letrend/kicad_db/_3Dmodels/SJ-63063B--3DModel-STEP-1.STEP

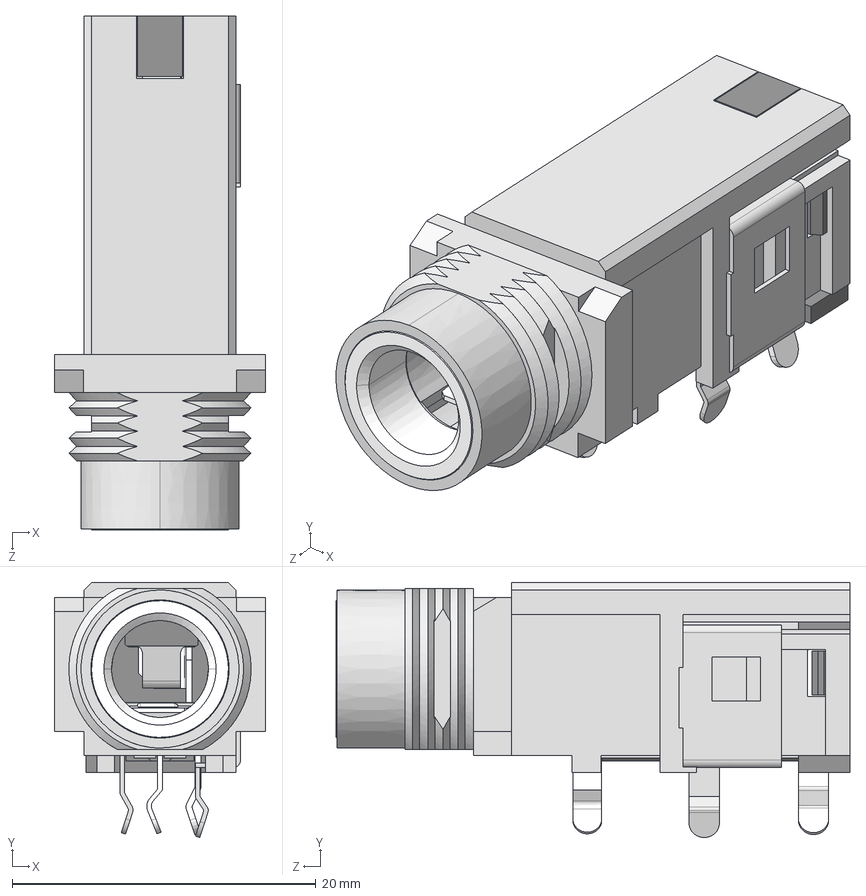
[picture p1: CAD file, 2025-12-29]
_3Dmodels/SJ-63063B--3DModel-STEP-1.STEP
13.9 x 16.8 x 33.9 mm
630BT-1
630LS-1
PRT0003-1
630C2-1
630GZ-1
