letrend/kicad_db/_3Dmodels/FH28K-20S-0.5SH.stp

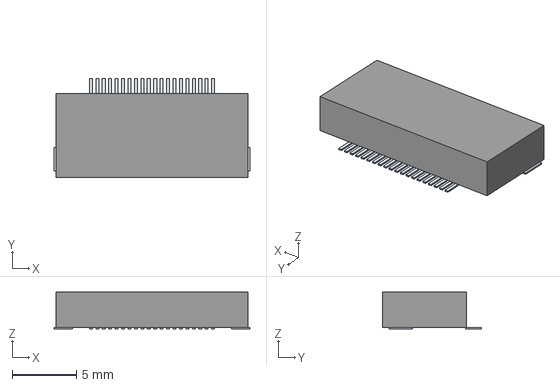
[picture p2: CAD file, 2025-12-13]
_3Dmodels/FH28K-20S-0.5SH.stp
15.2 x 7.67 x 2.85 mm
Pins
