letrend/kicad_db/_3Dmodels/UQFN20_NC_MCH.step

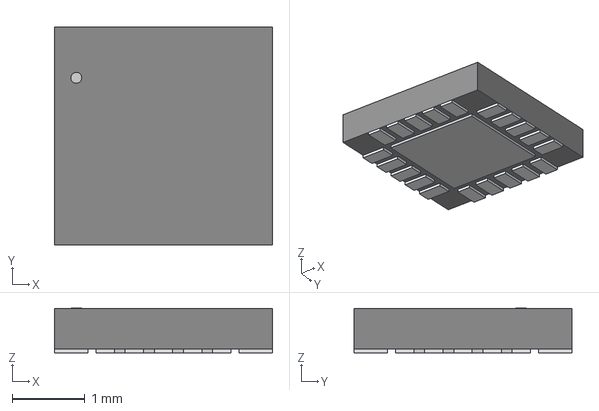
[picture p3: CAD file, 2025-12-13]
_3Dmodels/UQFN20_NC_MCH.step
3.00 x 3.00 x 0.612 mm
