letrend/kicad_db/_3Dmodels/MP6619 (QFN-19, 3x3).step

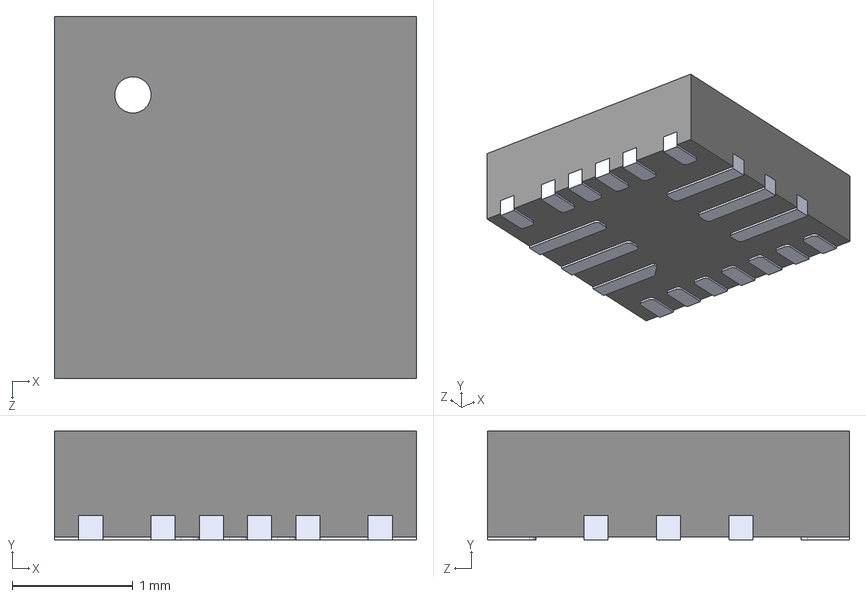
[picture p4: CAD file, 2025-12-13]
_3Dmodels/MP6619 (QFN-19, 3x3).step
3.00 x 0.9 x 3.00 mm
