letrend/kicad_db/_3Dmodels/A1308LLHLT-1-T.stp

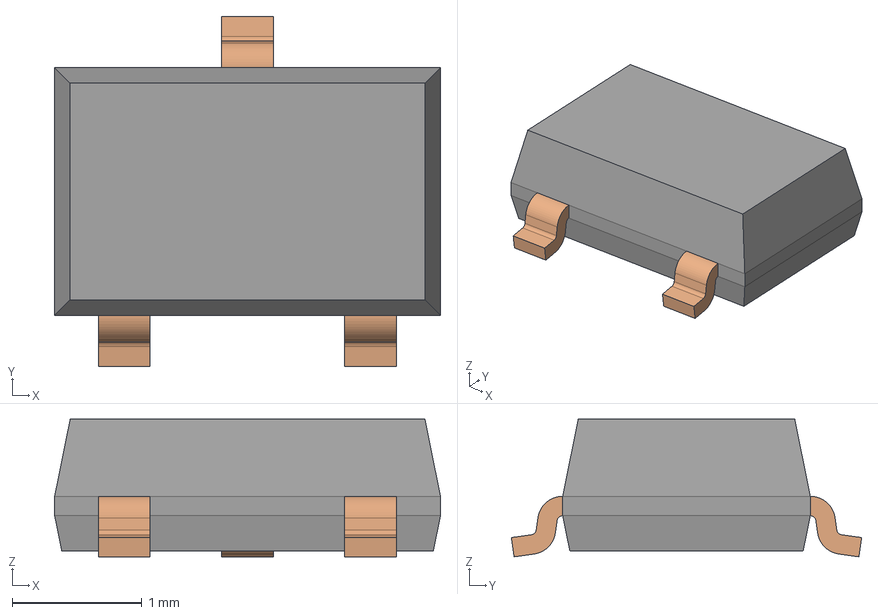
[picture p5: CAD file, 2025-10-07]
_3Dmodels/A1308LLHLT-1-T.stp
2.98 x 2.70 x 1.06 mm
LH1
LH2
LH3
LH4
LH5
LH6
LH-body
