letrend/kicad_db/_3Dmodels/DRV8825_STEPPER_MOTOR_DRIVER_CARRIER.step

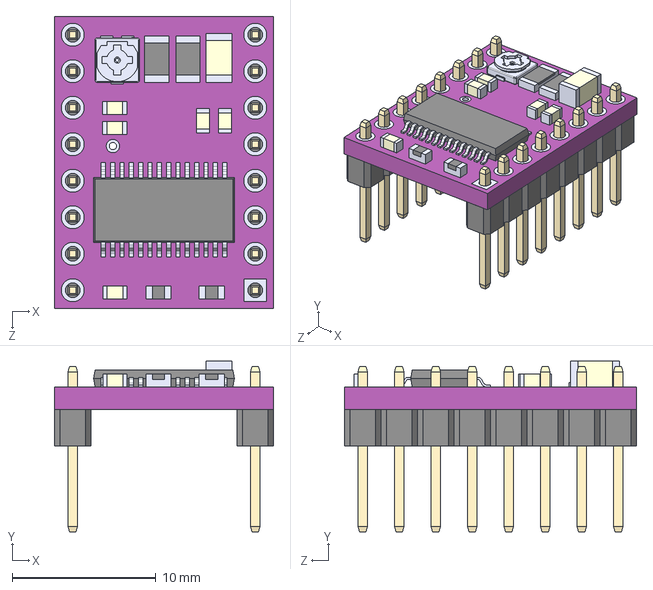
[picture p6: CAD file, 2025-08-23]
_3Dmodels/DRV8825_STEPPER_MOTOR_DRIVER_CARRIER.step
15.2 x 11.9 x 20.3 mm
