letrend/kicad_db/_3Dmodels/TSM-104-01-L-DH.stp

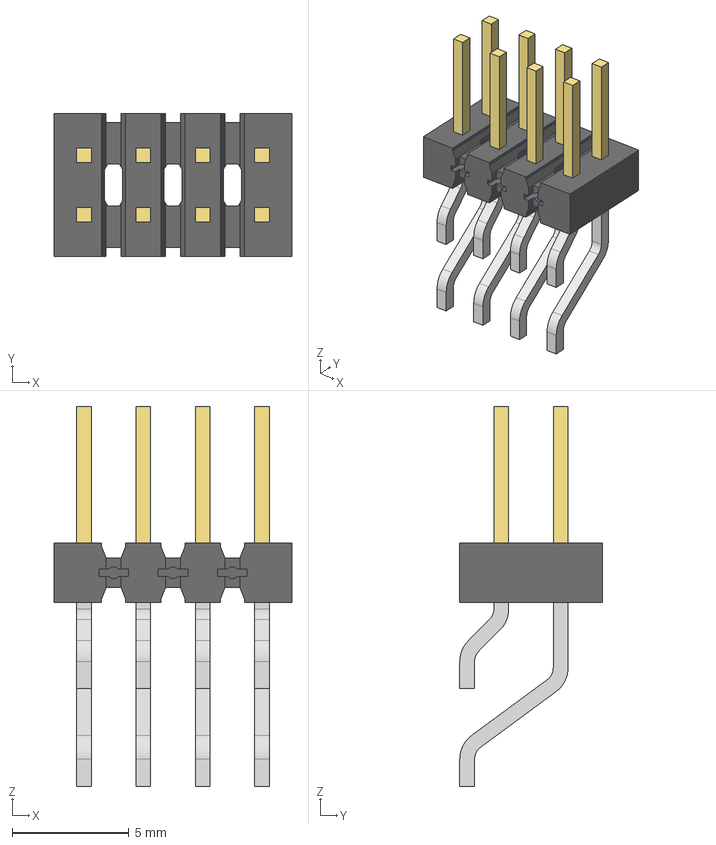
[picture p7: CAD file, 2025-07-05]
_3Dmodels/TSM-104-01-L-DH.stp
10.2 x 6.10 x 16.3 mm
TSM-104-01-DH_body
T-1S6-09-L(-01-4-DH)
T-1S6-09-L(-01-4-DH)2
