letrend/kicad_db/_3Dmodels/SS34.step

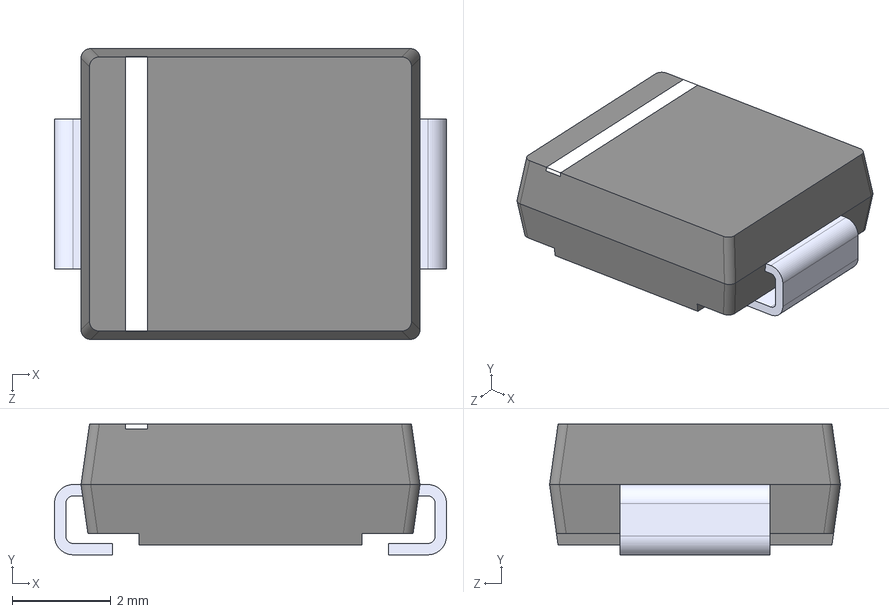
[picture p8: CAD file, 2025-05-21]
_3Dmodels/SS34.step
7.95 x 2.65 x 5.90 mm
