letrend/kicad_db/_3Dmodels/SBT-10X-UV-A120-AH380-22.step

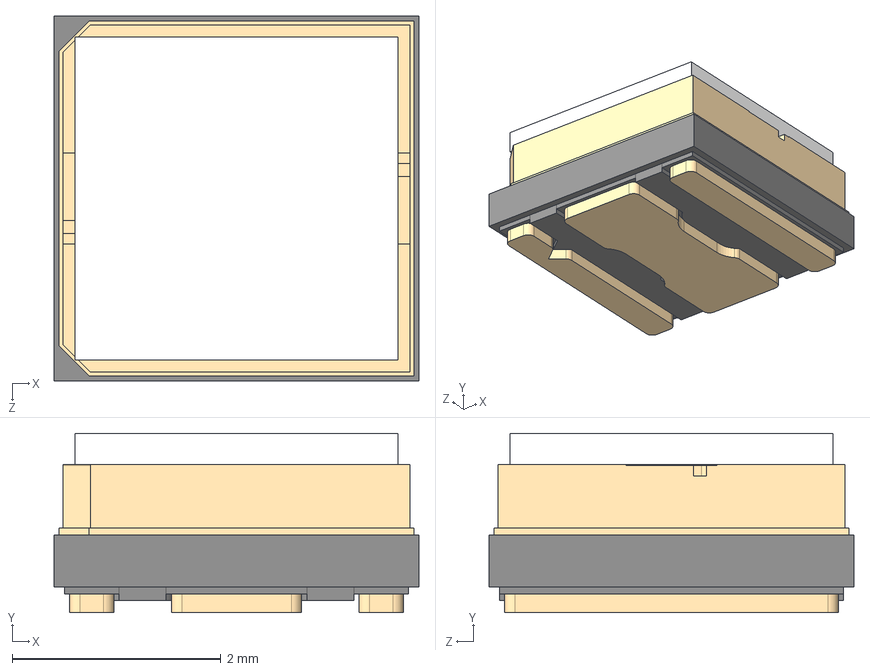
[picture p9: CAD file, 2025-05-21]
_3Dmodels/SBT-10X-UV-A120-AH380-22.step
3.50 x 1.72 x 3.50 mm
