letrend/kicad_db/_3Dmodels/16SVP3R3M.step

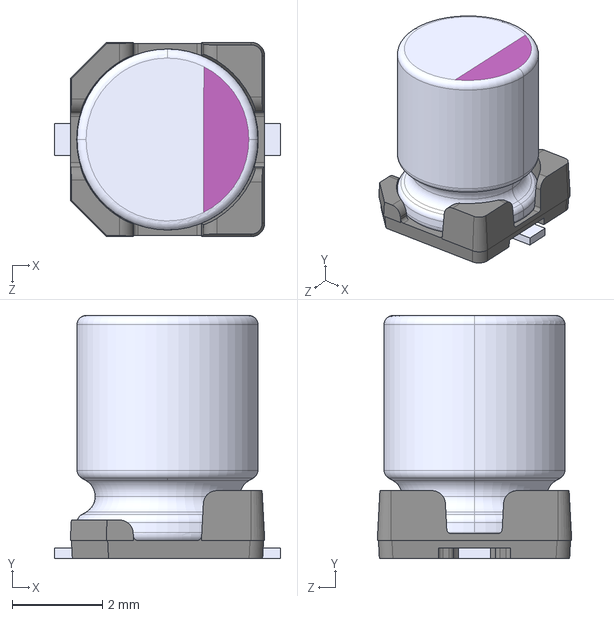
[picture p10: CAD file, 2025-05-21]
_3Dmodels/16SVP3R3M.step
5.00 x 5.37 x 4.30 mm
