letrend/kicad_db/_3Dmodels/SS54-HF.step

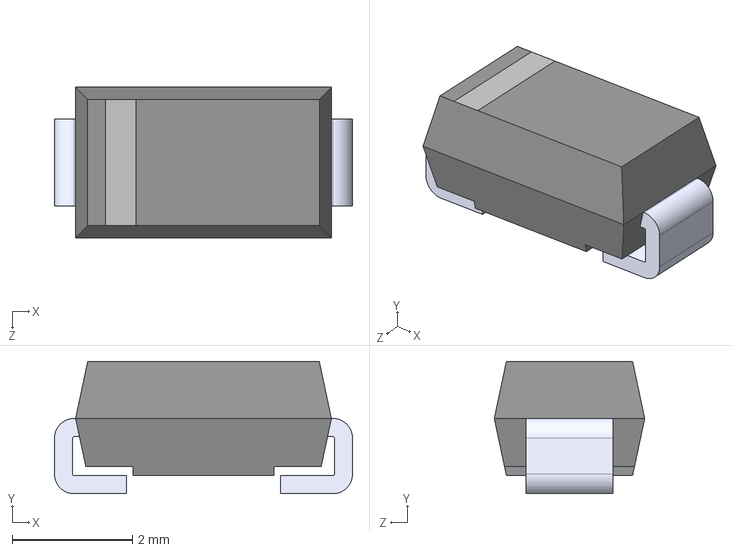
[picture p11: CAD file, 2025-05-21]
_3Dmodels/SS54-HF.step
4.95 x 2.20 x 2.50 mm
