letrend/kicad_db/_3Dmodels/TL082ID.step

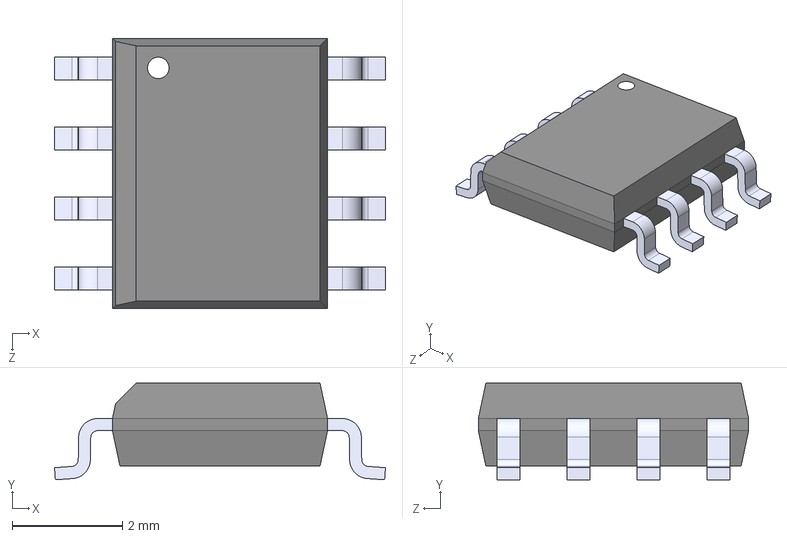
[picture p12: CAD file, 2025-05-21]
_3Dmodels/TL082ID.step
6.00 x 1.75 x 4.90 mm
