letrend/kicad_db/_3Dmodels/A1339LLETR-T.stp

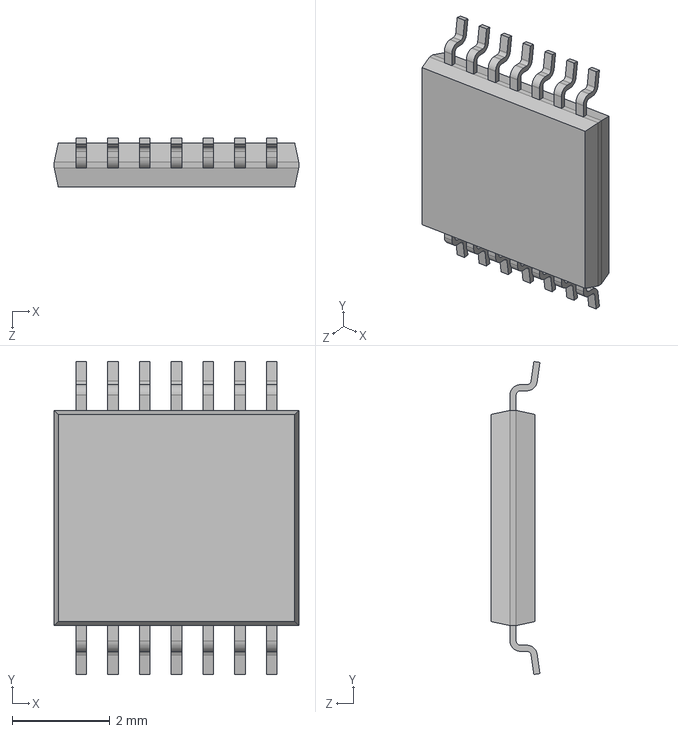
[picture p13: CAD file, 2025-05-21]
_3Dmodels/A1339LLETR-T.stp
5.00 x 6.40 x 1.00 mm
