letrend/kicad_db/_3Dmodels/c-1-338068-2-f-3d.stp

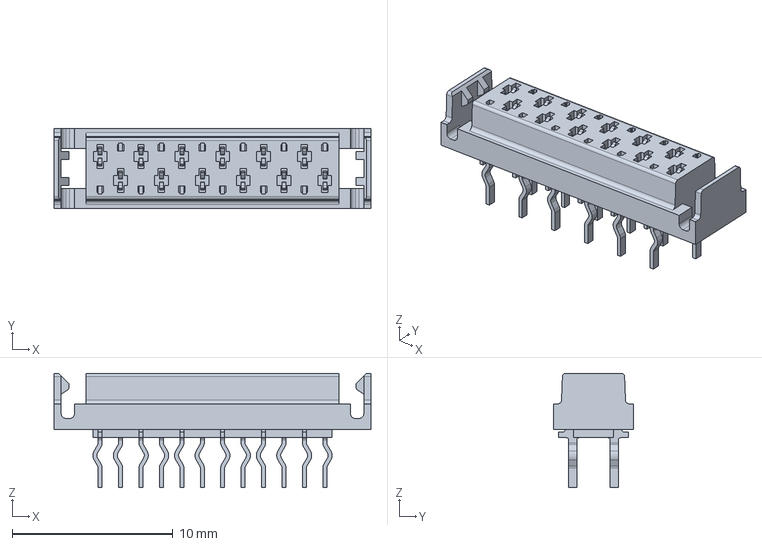
[picture p14: CAD file, 2025-05-21]
_3Dmodels/c-1-338068-2-f-3d.stp
19.7 x 5.00 x 7.10 mm
