letrend/kicad_db/_3Dmodels/c-1-188275-2-u-3d.stp

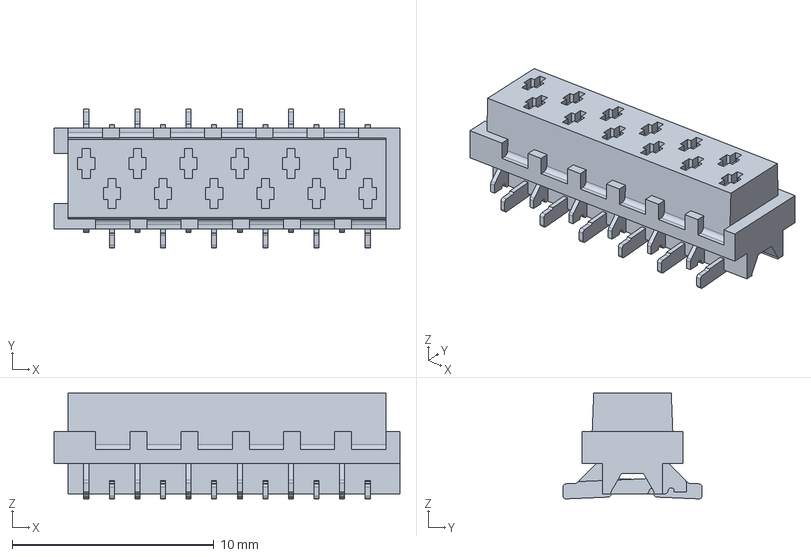
[picture p15: CAD file, 2025-05-21]
_3Dmodels/c-1-188275-2-u-3d.stp
17.2 x 6.90 x 5.25 mm
