letrend/kicad_db/_3Dmodels/6.3 SIZE CODE C6.stp

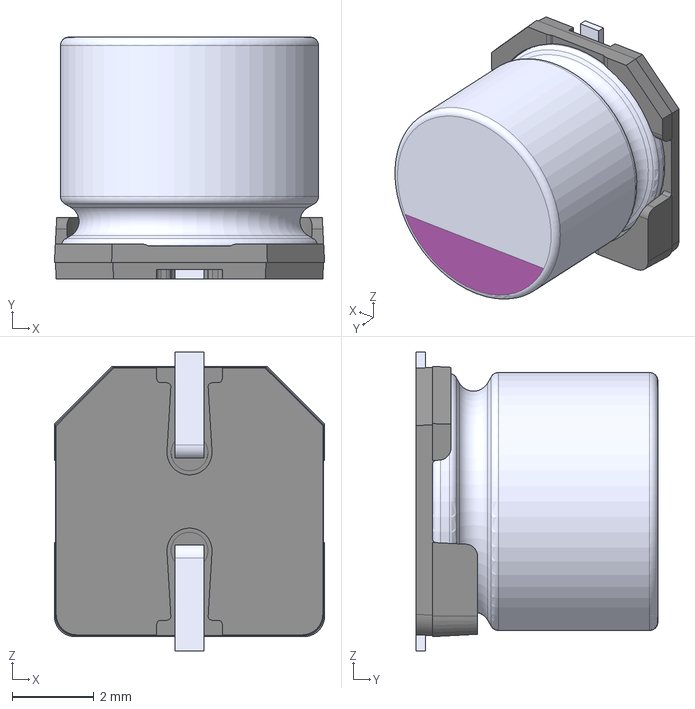
[picture p16: CAD file, 2024-07-14]
_3Dmodels/6.3 SIZE CODE C6.stp
6.60 x 5.90 x 7.30 mm
