letrend/kicad_db/_3Dmodels/#A915BY-470M=P3.step

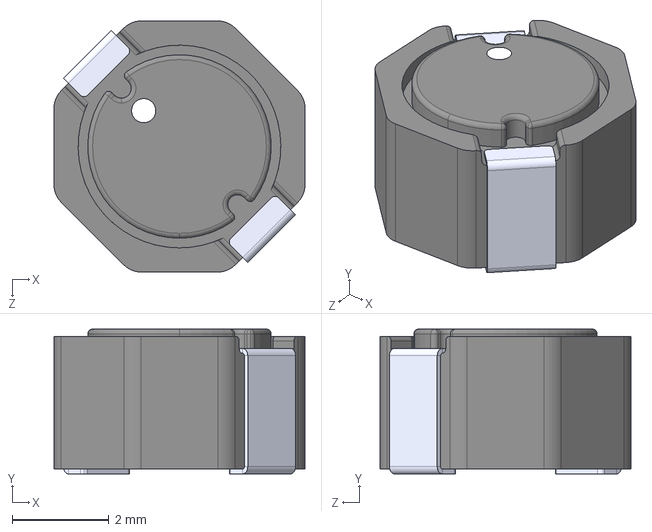
[picture p17: CAD file, 2024-07-14]
_3Dmodels/#A915BY-470M=P3.step
5.20 x 3.00 x 5.20 mm
