letrend/kicad_db/_3Dmodels/MAX1968EUI+.step

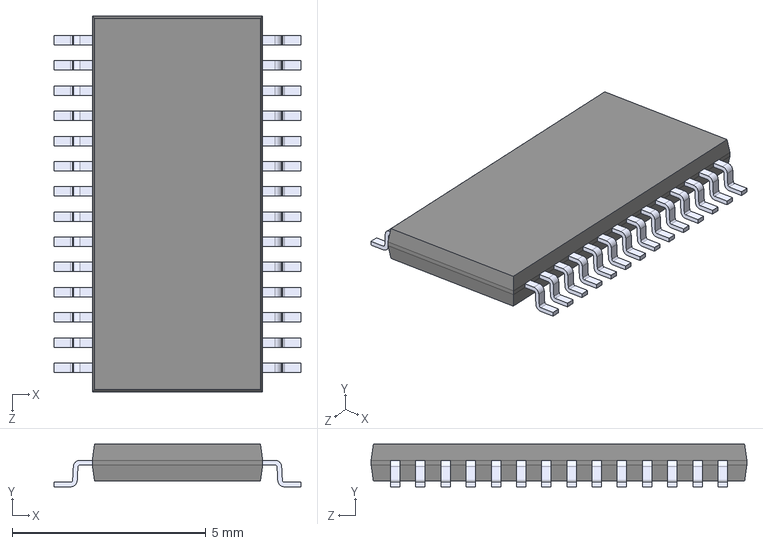
[picture p18: CAD file, 2024-07-14]
_3Dmodels/MAX1968EUI+.step
6.38 x 1.10 x 9.70 mm
