letrend/kicad_db/_3Dmodels/L1570P5DFB.step

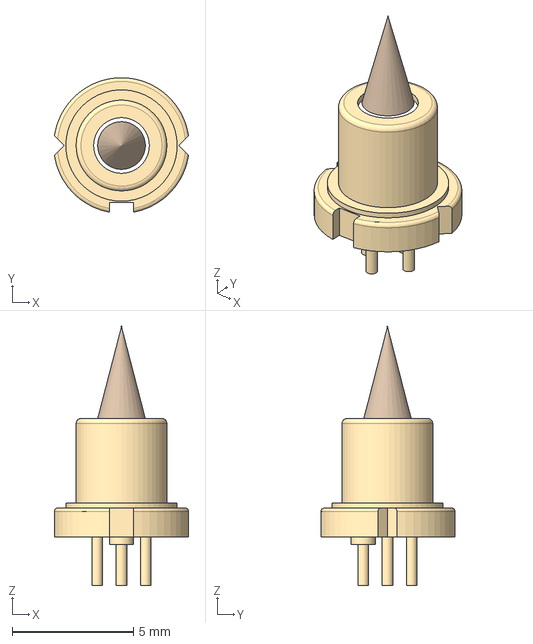
[picture p19: CAD file, 2024-07-07]
_3Dmodels/L1570P5DFB.step
5.54 x 5.55 x 10.7 mm
