letrend/kicad_db/_3Dmodels/LSIAPD-50-B-1A.step

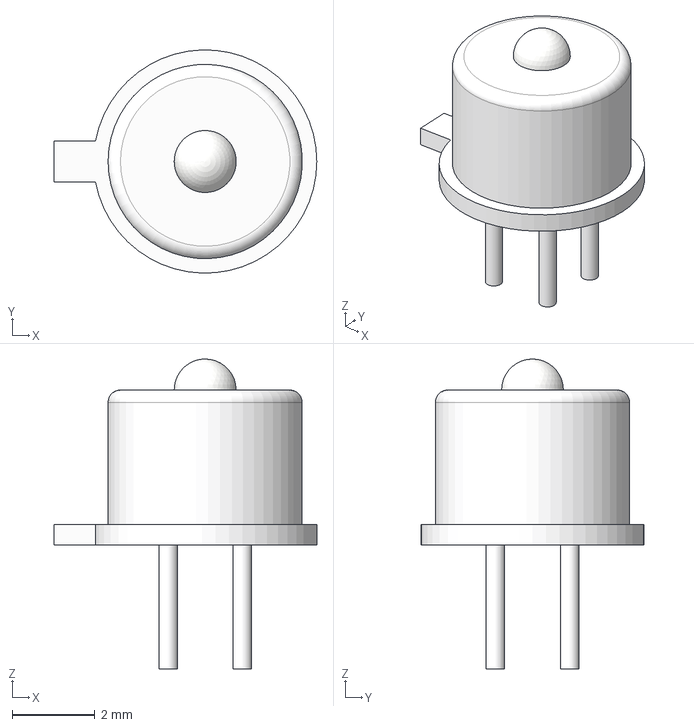
[picture p20: CAD file, 2024-07-07]
_3Dmodels/LSIAPD-50-B-1A.step
6.35 x 5.40 x 7.50 mm
