letrend/kicad_db/_3Dmodels/L1570P5DFB-Step.step

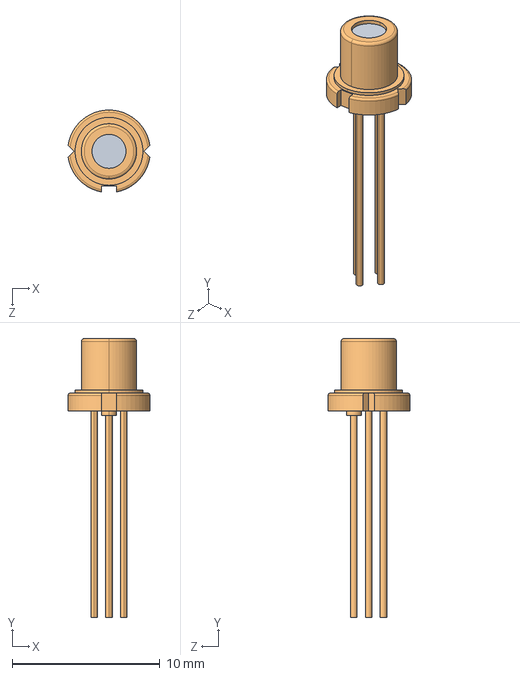
[picture p21: CAD file, 2024-07-07]
_3Dmodels/L1570P5DFB-Step.step
5.54 x 18.9 x 5.55 mm
