letrend/kicad_db/_3Dmodels/3214W-1-502E.step

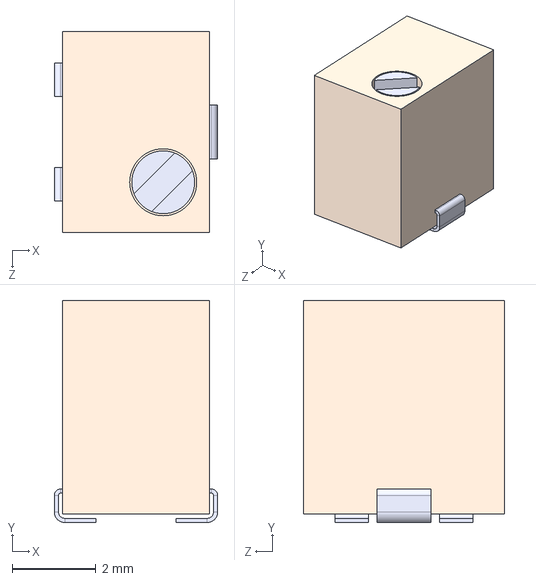
[picture p22: CAD file, 2024-06-29]
_3Dmodels/3214W-1-502E.step
3.90 x 5.30 x 4.80 mm
