letrend/kicad_db/_3Dmodels/PCB.SMAFRA.HT--3DModel-STEP-56544.STEP

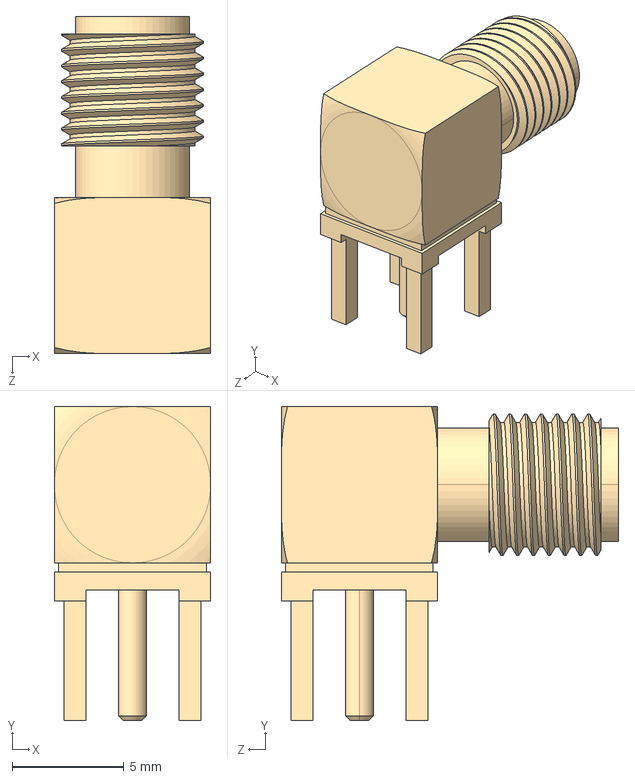
[picture p23: CAD file, 2024-06-29]
_3Dmodels/PCB.SMAFRA.HT--3DModel-STEP-56544.STEP
7.00 x 14.1 x 15.1 mm
