letrend/kicad_db/_3Dmodels/ASFL1-10.000MHZ-EK-T.step

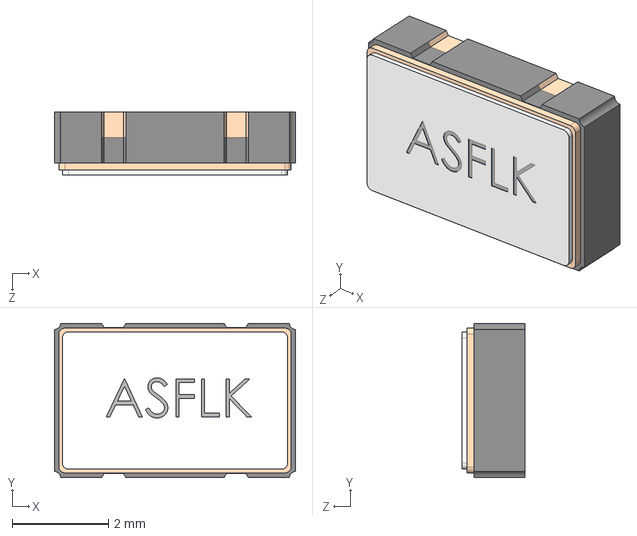
[picture p24: CAD file, 2024-06-28]
_3Dmodels/ASFL1-10.000MHZ-EK-T.step
5.00 x 3.20 x 1.30 mm
