letrend/kicad_db/_3Dmodels/P7A2110PQWDRBRQ1--3DModel-STEP-56544.step

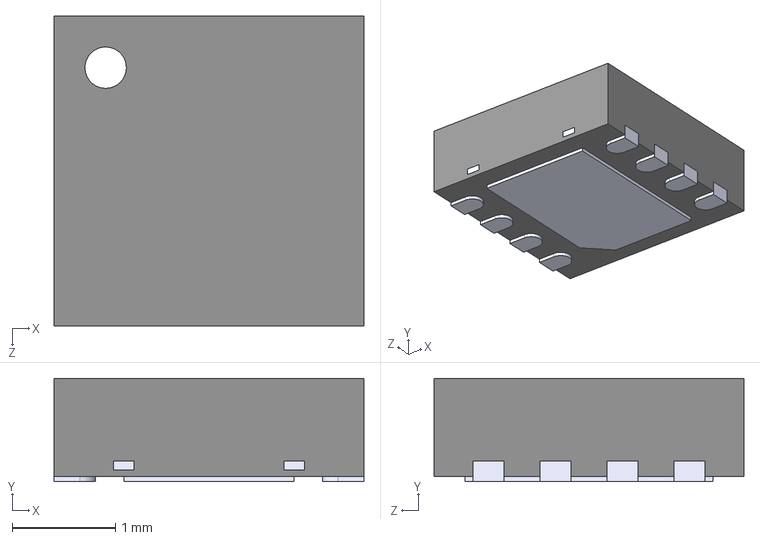
[picture p25: CAD file, 2024-06-28]
_3Dmodels/P7A2110PQWDRBRQ1--3DModel-STEP-56544.step
3.00 x 1.00 x 3.00 mm
