letrend/kicad_db/_3Dmodels/ASV-10.000MHZ-EJ-T.step

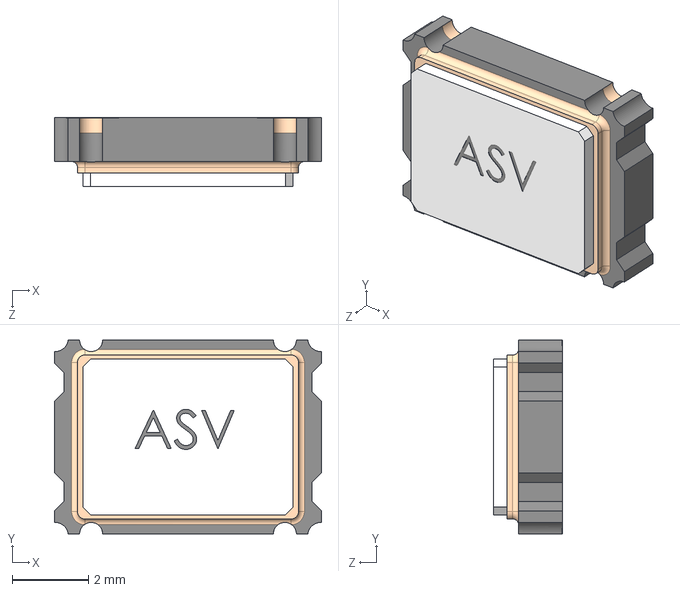
[picture p26: CAD file, 2024-06-15]
_3Dmodels/ASV-10.000MHZ-EJ-T.step
7.00 x 5.08 x 1.80 mm
