letrend/kicad_db/_3Dmodels/EVP-ASAC1A.step

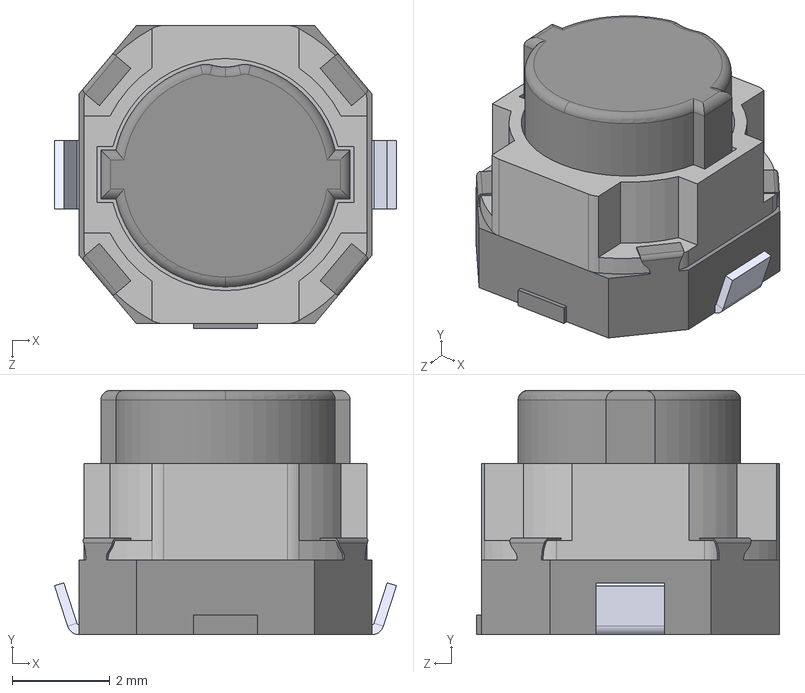
[picture p27: CAD file, 2024-06-15]
_3Dmodels/EVP-ASAC1A.step
7.00 x 5.00 x 6.20 mm
