letrend/kicad_db/_3Dmodels/AS6501-FLQM.step

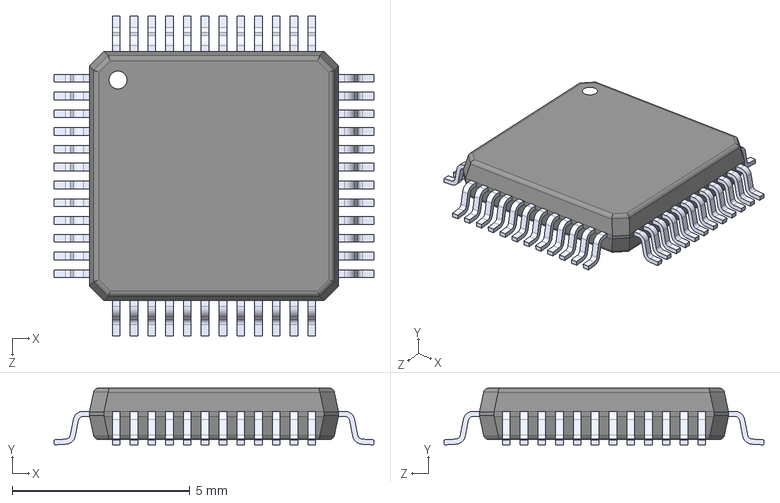
[picture p28: CAD file, 2024-05-25]
_3Dmodels/AS6501-FLQM.step
9.00 x 1.60 x 9.00 mm
