letrend/kicad_db/_3Dmodels/QFN50P300X300X80-17N.step

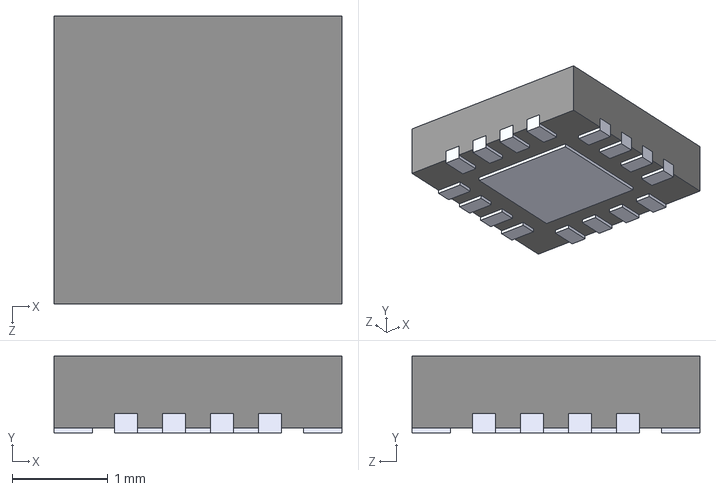
[picture p29: CAD file, 2023-09-10]
_3Dmodels/QFN50P300X300X80-17N.step
3.00 x 0.8 x 3.00 mm
