letrend/kicad_db/_3Dmodels/LTC2602IMS8_PBF.step

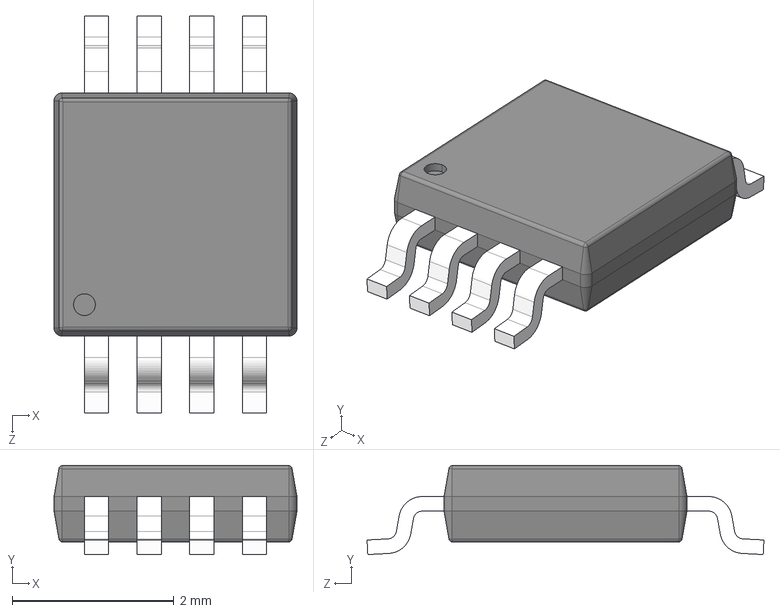
[picture p30: CAD file, 2023-09-06]
_3Dmodels/LTC2602IMS8_PBF.step
3.00 x 1.10 x 4.90 mm
