letrend/kicad_db/_3Dmodels/1-282834-2.step

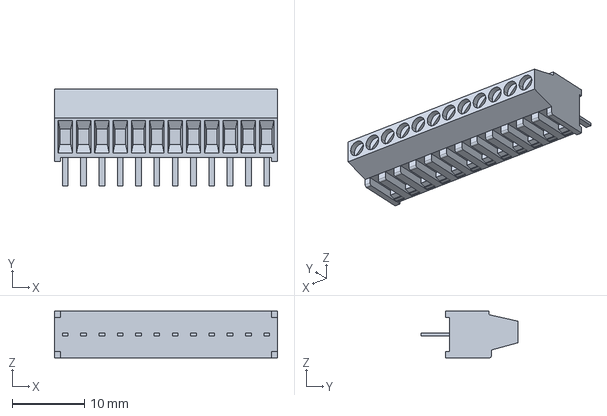
[picture p31: CAD file, 2023-05-20]
_3Dmodels/1-282834-2.step
30.9 x 13.4 x 6.50 mm
