letrend/kicad_db/_3Dmodels/1-282834-0.step

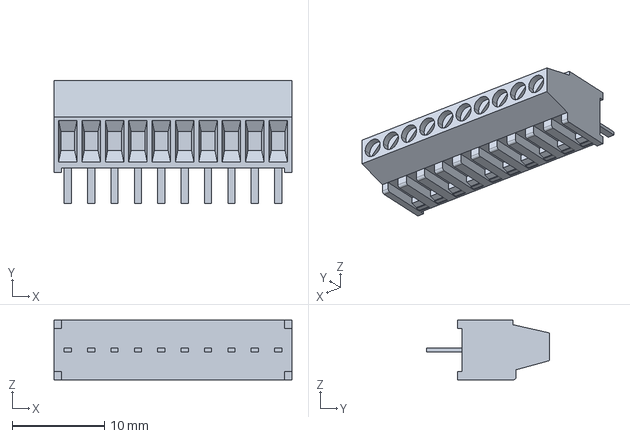
[picture p32: CAD file, 2023-05-11]
_3Dmodels/1-282834-0.step
25.9 x 13.4 x 6.50 mm
