letrend/kicad_db/_3Dmodels/RCWCTE.step

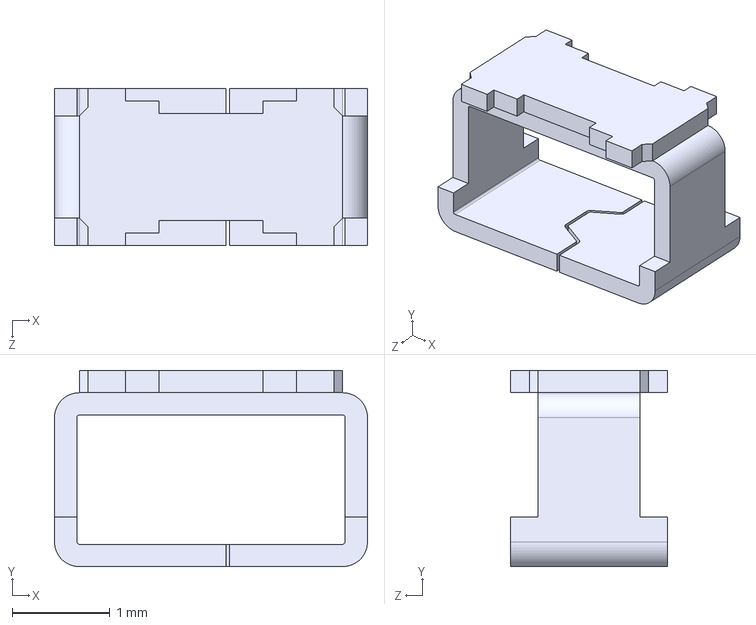
[picture p33: CAD file, 2023-05-11]
_3Dmodels/RCWCTE.step
3.20 x 2.01 x 1.60 mm
