letrend/kicad_db/_3Dmodels/J1B1211CCD.stp

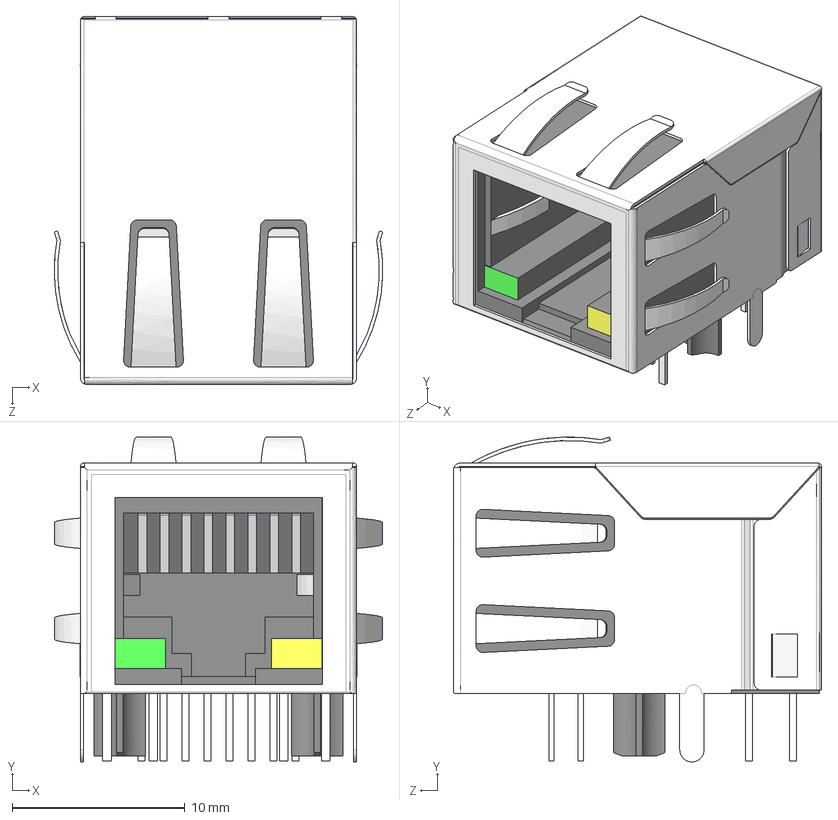
[picture p34: CAD file, 2023-05-11]
_3Dmodels/J1B1211CCD.stp
19.0 x 18.8 x 21.3 mm
