letrend/kicad_db/_3Dmodels/713-1436_037-000.stp

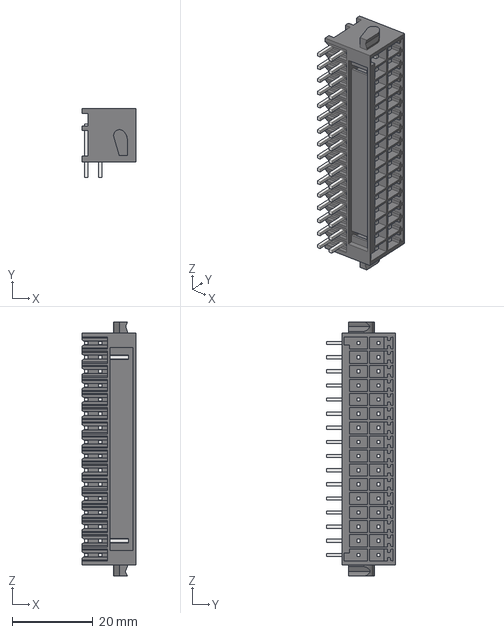
[picture p35: CAD file, 2023-04-30]
_3Dmodels/713-1436_037-000.stp
13.5 x 17.1 x 63.0 mm
