letrend/kicad_db/_3Dmodels/sbm-120-uv.step

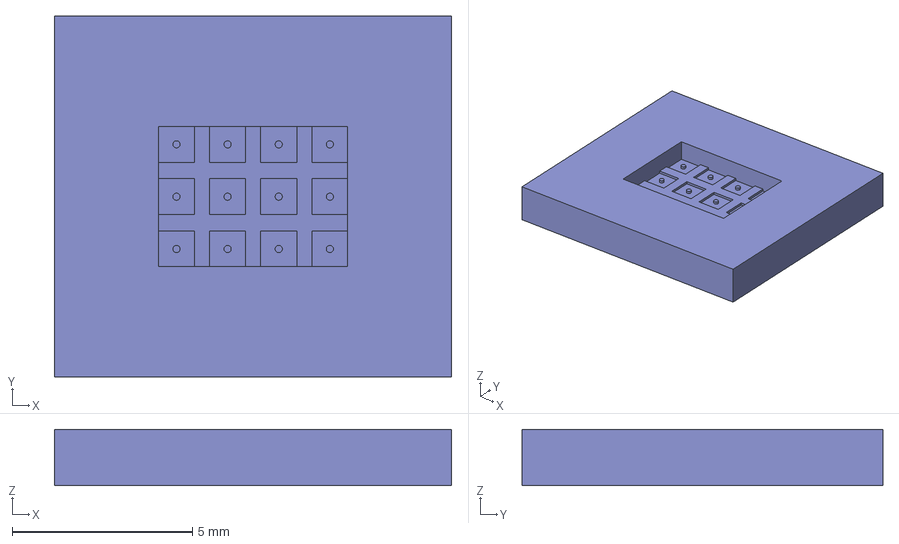
[picture p36: CAD file, 2023-04-29]
_3Dmodels/sbm-120-uv.step
11.0 x 10.0 x 1.56 mm
