letrend/kicad_db/_3Dmodels/TLI493d-W2BW.stp

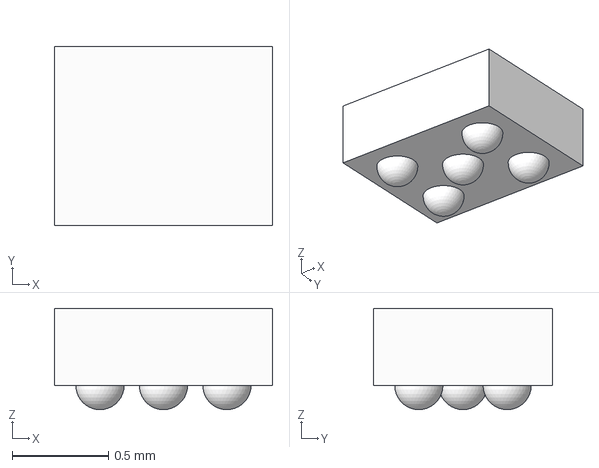
[picture p37: CAD file, 2023-04-02]
_3Dmodels/TLI493d-W2BW.stp
1.13 x 0.93 x 0.525 mm
