letrend/kicad_db/_3Dmodels/SAMTEC-SQW-118-01-X-D.step

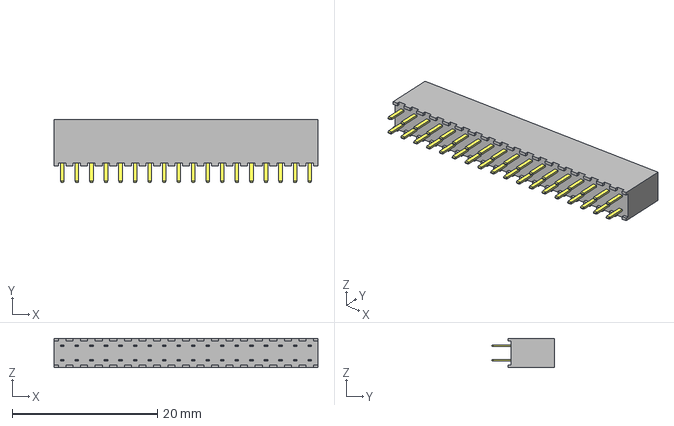
[picture p38: CAD file, 2023-04-01]
_3Dmodels/SAMTEC-SQW-118-01-X-D.step
36.3 x 8.64 x 4.00 mm
P1SQW-118-01-L-D
S1SQW-118-01-L-D
