letrend/kicad_db/_3Dmodels/TE_1-1734839-0_1x10.step

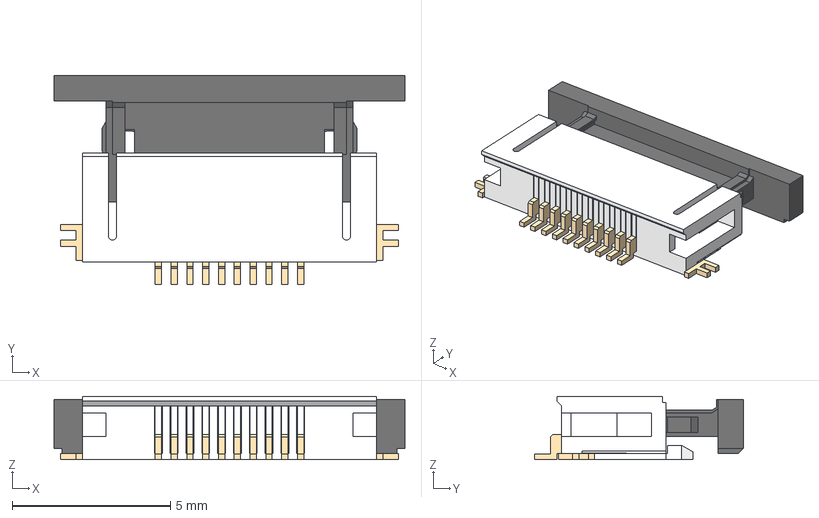
[picture p39: CAD file, 2022-04-30]
_3Dmodels/TE_1-1734839-0_1x10.step
11.1 x 6.60 x 2.00 mm
