letrend/kicad_db/_3Dmodels/tcut1800.step

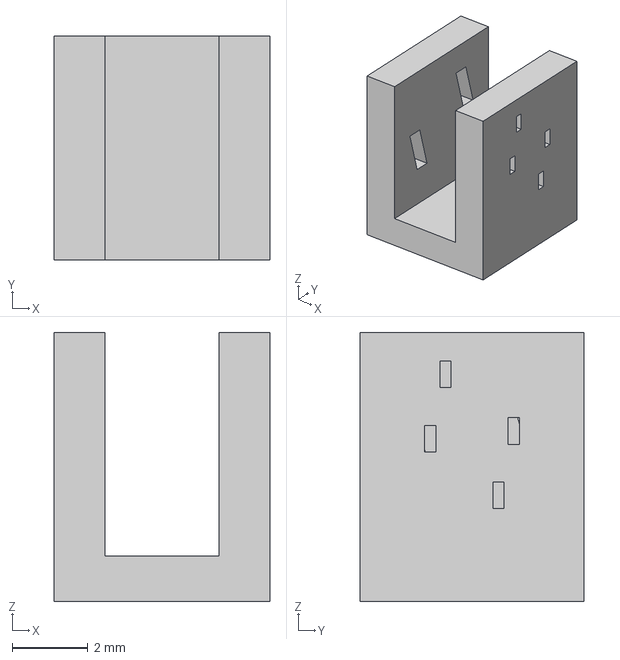
[picture p40: CAD file, 2021-05-09]
_3Dmodels/tcut1800.step
5.70 x 5.90 x 7.10 mm
