letrend/kicad_db/_3Dmodels/MC2016K25.0000C16ESH.stp

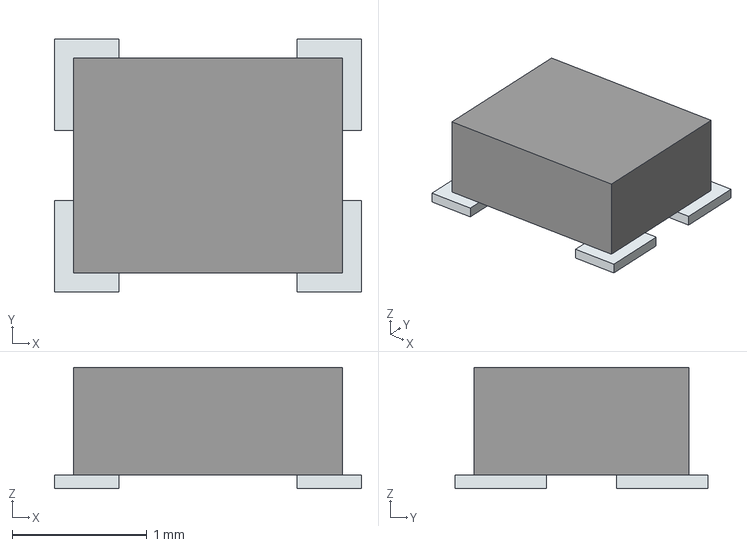
[picture p41: CAD file, 2020-10-24]
_3Dmodels/MC2016K25.0000C16ESH.stp
2.28 x 1.88 x 0.9 mm
Pins
