letrend/kicad_db/(list of files, cad)

Other CAD files:
_3Dmodels/2286211-3.stp
