letrend/kicad_db/(commit log)

2020-10-08 with correct tli5012 footprint
2020-10-24 trinamic components
    [MC2016K25.0000C16ESH.stp]
2020-10-27 more tmc footprints
2021-01-18 with 12bit 2channel adc
2021-02-27 with spring pin
2021-03-18 with stepper driver
2021-12-30 with inductor footprint
2022-01-01 with 3d model fpc connector
    [TE_1-1734839-0_1x10.step]
2022-04-30 motor driver
2022-05-03 with footprint
2022-05-14 started schematics
2023-03-08 i2c multiplexer
2023-04-01 with tli493 and icewerx socket
    [SAMTEC-SQW-118-01-X-D.step]
2023-04-02 with tli493d-w2bw step
    [TLI493d-W2BW.stp]
2023-04-07 sbm-120-uv footprint
2023-04-29 with led step
    [sbm-120-uv.step]
2023-04-29 with dacs and teensy 4.1
2023-04-30 with current limiting switch
    [TPS2HB50BQPWPRQ1.step]
2023-04-30 with wago connector
    [713-1436_037-000.stp]
2023-05-10 with optical switch and dc-dc converter
2023-05-11 with test points ethernet jack power smd connectors
    [1-282834-0.step, J1B1211CCD.stp, RCWCTE.step]
2023-05-20 with buck converter 5V 2A
    [1-282834-2.step]
2023-09-06 16bit dac
    [LTC2602IMS8_PBF.step]
2023-09-10 log tia ic
    [QFN50P300X300X80-17N.step]
2024-05-25 with tof
    [AS6501-FLQM.step]
2024-05-30 laser footprint
2024-06-15 with 10MHz clock and push button
    [ASV-10.000MHZ-EJ-T.step, EVP-ASAC1A.step]
2024-06-16 with sma connector
2024-06-26 with laser driver ganfet
2024-06-28 with ldo and clock
    [ASFL1-10.000MHZ-EK-T.step, TPS7A21XXPQWDRBRQ1.STEP]
2024-06-29 sma and poti
    [3214W-1-502E.step, PCB.SMAFRA.HT--3DModel-STEP-56544.STEP]
2024-07-14 with arduino nano esp step
2024-07-14 3d models
    [#A915BY-470M=P3.step, 6.3 SIZE CODE C6.stp, MAX1968EUI+.step, P7A2110PQWDRBRQ1--3DModel-STEP-56544.step]
2024-08-14 with usb c connector
2025-03-28 cc driver
2025-03-28 more stuff
    [SBT-10X-UV-A120-AH380-22.step, SS34.step]
2025-03-29 more components
    [16SVP3R3M.step, SS54-HF.step]
2025-06-30 with 100pos connector wsmd
2025-07-05 more connectors
    [TSM-104-01-L-DH.stp]
2025-08-23 with voltera arduino uno template
2025-09-03 with arduino nano esp
2025-10-01 wih hall sensor
2025-10-07 3d model
    [A1308LLHLT-1-T.stp]
