letrend/kicad_db/(notices)

Notices in the files:
_3Dmodels/713-1436_037-000.stp:
author */ ('License CC BY-ND 4.0'),
